Mo3tasemO/Graduation_Project/README.md

# Graduation Project

This repository will be for the Graduation Project.
