Mo3tasemO/Graduation_Project/Hardware_Design/Mind_Speak_(Main_Board)/BOM_LIST/Mind_Speak_(Main_Board).csv

Designator | Qty | Comment | DNP | Exclude from BOM | Exclude from Board | VENDOR | LINK | Footprint | Datasheet
C1,C29,C31,C33,C42,C43 | 6 | 10uF |  |  |  | LCSC | https://www.lcsc.com/product-detail/C710916.html?s_z=n_q_GRM188C80G106KE47D | PCM_SparkFun-Capacitor:C_0603_1608Metric | https://cdn.sparkfun.com/assets/8/a/4/a/5/Kemet_Capacitor_Datasheet.pdf
C2,C10,C11,C17,C18,C26,C32,C41 | 8 | 0.1uF |  |  |  | Mouser | https://www2.mouser.com/en/ProductDetail/YAGEO/CC0402KRX7R7BB104?qs=AgBp2OyFlx%252BSOyhfyS7hpw%3D%3D | PCM_SparkFun-Capacitor:C_0402_1005Metric | https://cdn.sparkfun.com/assets/8/a/4/a/5/Kemet_Capacitor_Datasheet.pdf
C3,C6,C7,C13,C14,C19,C20,C21,C24,C30,C34,C35 | 12 | 1.0uF |  |  |  | Mouser | https://www2.mouser.com/en/ProductDetail/YAGEO/CC0402KRX7R5BB105?qs=HEu%2FF%2FCqxzJ6VbuCv2R5Zg%3D%3D | PCM_SparkFun-Capacitor:C_0402_1005Metric | https://cdn.sparkfun.com/assets/8/a/4/a/5/Kemet_Capacitor_Datasheet.pdf
C4,C16 | 2 | 100uF |  |  |  | Mouser | https://www2.mouser.com/en/ProductDetail/YAGEO/CC1206MKX5R5BB107?qs=57cj7OiSijmA1unmqOkHVw%3D%3D | PCM_SparkFun-Capacitor:C_1206_3216Metric | https://mm.digikey.com/Volume0/opasdata/d220001/medias/docus/7134/c02e.pdf
C5,C9,C12,C15,C25,C27 | 6 | 2.2uF |  |  |  | Mouser | https://www2.mouser.com/en/ProductDetail/Murata-Electronics/GRM155R61C225KE44D?qs=K0Sa7bCb58LeAAXFhnh74A%3D%3D | PCM_SparkFun-Capacitor:C_0402_1005Metric | https://cdn.sparkfun.com/assets/8/a/4/a/5/Kemet_Capacitor_Datasheet.pdf
C8,C22,C28,C36,C38 | 5 | 0.001uF |  |  |  | **Mouser | https://eu.mouser.com/en/ProductDetail/TDK/CKCL44X7R1H102M085AA?qs=NRhsANhppD9%2Fh8FD6DWiRQ%3D%3D | TDK_Library:CKCL44_TDK | CKCL44X7R1H102M085AA
C23 | 1 | 0.01uF |  |  |  | Mouser | https://www2.mouser.com/en/ProductDetail/YAGEO/CC0402KRX7R7BB103?qs=AgBp2OyFlx8cKvXdhdEm3Q%3D%3D | SparkFun-Capacitor:C_0402_1005Metric | https://cdn.sparkfun.com/assets/8/a/4/a/5/Kemet_Capacitor_Datasheet.pdf
C37 | 1 | 1.0nF |  |  |  | Mouser | https://www2.mouser.com/en/ProductDetail/YAGEO/CC0402KRX7R7BB102?qs=cQA0dC2V9ENjYxMNJXN2bg%3D%3D | PCM_SparkFun-Capacitor:C_0402_1005Metric | https://cdn.sparkfun.com/assets/8/a/4/a/5/Kemet_Capacitor_Datasheet.pdf
C39,C40 | 2 | 18pF |  |  |  | Mouser | https://www2.mouser.com/en/ProductDetail/YAGEO/CC0402JRNPO9BN180?qs=AgBp2OyFlx8ARaqa%252Br5VgQ%3D%3D | PCM_SparkFun-Capacitor:C_0402_1005Metric | https://cdn.sparkfun.com/assets/8/a/4/a/5/Kemet_Capacitor_Datasheet.pdf
D1,D2,D3,D4,D5,D6 | 6 | TPD4E1B06DCKR |  |  |  | Mouser | https://www2.mouser.com/en/ProductDetail/Texas-Instruments/TPD4E1B06DCKR?qs=FBI%252BX3tnPf1Bt8uBkGhcNg%3D%3D | TI_Library:TVS_TPD4E1B06DCKR
D7 | 1 | Blue |  |  |  | Mouser | https://www2.mouser.com/en/ProductDetail/LITEON/LTST-C193TBKT-5A?qs=xIkB7y1OTorvzzuuxuVkOA%3D%3D | PCM_SparkFun-LED:LED_0603_1608Metric_Blue | https://media.digikey.com/pdf/Data%20Sheets/Rohm%20PDFs/SMLE12_Series_Rev2.0_2007.pdf
J1 | 1 | microSD |  |  |  | Mouser | https://www2.mouser.com/en/ProductDetail/Same-Sky/MSD-1-A?qs=Z%252BL2brAPG1Ip18XLC4tUPQ%3D%3D | SparkFun-Connector:CUI_MSD-1-A | https://cdn.sparkfun.com/assets/a/d/6/0/8/microSD_Datasheet_msd-1-a.pdf
J2,J4 | 2 | Conn_01x04_Pin |  |  |  | MicroOhm | https://microohm-eg.com/pin-header-2-54mm-1x40-pin-male-single-row-straight-short-header-strip/ | Connector_PinHeader_2.54mm:PinHeader_1x04_P2.54mm_Vertical
J3 | 1 | Conn_02x13_Odd_Even |  |  |  | MicroOhm | https://microohm-eg.com/2-54mm-0-100-pin-header-male-2x40-right-angle/ | Connector_PinHeader_2.54mm:PinHeader_2x13_P2.54mm_Horizontal
J5 | 1 | Conn_01x08_Pin |  |  |  | MicroOhm | https://microohm-eg.com/pin-header-2-54mm-1x40-pin-male-single-row-straight-short-header-strip/ | Connector_PinHeader_2.54mm:PinHeader_1x08_P2.54mm_Vertical
J6 | 1 | Conn_01x02_Pin |  |  |  | MicroOhm | https://microohm-eg.com/pin-header-2-54mm-1x40-pin-male-single-row-straight-short-header-strip/ | Connector_PinHeader_2.54mm:PinHeader_1x02_P2.54mm_Vertical
J7,J8 | 2 | Conn_01x05_Pin |  |  |  | MicroOhm | https://microohm-eg.com/pin-header-2-54mm-1x40-pin-male-single-row-straight-short-header-strip/ | Connector_PinHeader_2.54mm:PinHeader_1x05_P2.54mm_Vertical
P1 | 1 | S2B-PH-SM4-TB_LF__SN_ |  |  |  | LCSC | https://www.lcsc.com/product-detail/C295747.html | JST_Library:JST_S2B-PH-SM4-TB_LF__SN_
R1 | 1 | 1M |  |  |  | Mouser | https://www2.mouser.com/en/ProductDetail/YAGEO/RC0402JR-071ML?qs=uM1JSSdPjOCNcwoUm19Cag%3D%3D | SparkFun-Resistor:R_0402_1005Metric | https://www.vishay.com/docs/20035/dcrcwe3.pdf
R2 | 1 | 1K |  |  |  | Mouser | https://www2.mouser.com/en/ProductDetail/YAGEO/RT0402FRE071KL?qs=BXCcY9r%252B08AJmLKodK5LLA%3D%3D | SparkFun-Resistor:R_0402_1005Metric | https://www.vishay.com/docs/20035/dcrcwe3.pdf
R3,R4 | 2 | 470K |  |  |  | Mouser | https://www2.mouser.com/en/ProductDetail/YAGEO/RC0402JR-07470KL?qs=uM1JSSdPjODkyS3O7Vrt5Q%3D%3D | SparkFun-Resistor:R_0402_1005Metric | https://www.vishay.com/docs/20035/dcrcwe3.pdf
RN1,RN2,RN3,RN4,RN5 | 5 | CAY16-2201F4LF |  |  |  | Mouser | https://www2.mouser.com/en/ProductDetail/Bourns/CAY16-2201F4LF?qs=tEaODSGlU8NX5flyk%2FHGvg%3D%3D | Bourns_Library:RESCAF80P320X160X60-8N
S1 | 1 | SSSS811101 |  |  |  | LCSC | https://www.lcsc.com/product-detail/C109335.html | ALPS_Library:SW_SSSS811101
SW1,SW2,SW3 | 3 | SW_MEC_5E |  |  |  | Mouser | https://www2.mouser.com/en/ProductDetail/CK/PTS810SJK250SMTR-LFS?qs=Imq1NPwxi77Ow0tzRIznfA%3D%3D | Button_Switch_SMD:SW_Push_1P1T_NO_Vertical_Wuerth_434133025816 | https://www.apem.com/medias/download/MEC_switches_serie_MULTIMEC5E.pdf
U1 | 1 | SN74LVC1G32DCKR |  |  |  | Mouser | https://www2.mouser.com/en/ProductDetail/Texas-Instruments/SN74LVC1G32DCKR?qs=rshUhwi3fbYur8p35NB%252BLQ%3D%3D | TI_Library:SOT65P210X110-5N
U2 | 1 | TPS60403DBV |  |  |  | LCSC | https://www.lcsc.com/product-detail/C11338.html?s_z=n_q_TPS60403DBVR | Package_TO_SOT_SMD:SOT-23-5 | https://www.ti.com/lit/ds/symlink/tps60401.pdf
U3 | 1 | CDBU0130L |  |  |  | Mouser | https://www2.mouser.com/en/ProductDetail/Comchip-Technology/CDBU0130L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 | Comchip_Library:CDBU | CDBU0130L
U4 | 1 | LIS3DH |  |  |  | Mouser | https://www2.mouser.com/en/ProductDetail/STMicroelectronics/LIS3DHTR?qs=6la6oa3D8xzhXYax3cEo4w%3D%3D | PCM_SparkFun-Sensor:ST_LGA-16_3x3mm_P0.5mm_5x3 | https://www.st.com/en/mems-and-sensors/lis3dh.html
U5 | 1 | LP5907MFX-3.3 |  |  |  | Mouser | https://www2.mouser.com/en/ProductDetail/Texas-Instruments/LP5907MFX-3.3-NOPB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 | PCM_SparkFun-Semiconductor-Standard:SOT23-5 | http://www.ti.com/lit/ds/symlink/lp5907.pdf
U6 | 1 | TPS72325DBVR |  |  |  | Mouser | https://www.lcsc.com/product-detail/C69932.html?s_z=n_q_TPS72325DBVR | Package_TO_SOT_SMD:SOT-23-5 | https://www.ti.com/lit/ds/symlink/tps723.pdf
U7 | 1 | TLV70025_SOT23-5 |  |  |  | Mouser | https://www2.mouser.com/en/ProductDetail/Texas-Instruments/TLV70025QDDCRQ1?qs=NiBvnJE4bX1tmxoZbCukhA%3D%3D | Package_TO_SOT_SMD:SOT-23-5 | http://www.ti.com/lit/ds/symlink/tlv700.pdf
U8 | 1 | ADS1299 |  |  |  | Mouser | https://www2.mouser.com/en/ProductDetail/Texas-Instruments/ADS1299IPAG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 | Package_QFP:TQFP-64_10x10mm_P0.5mm | https://www.ti.com/lit/ds/symlink/ads1299.pdf
U9 | 1 | NINA-B30x |  |  |  | Mouser | https://www2.mouser.com/en/ProductDetail/u-blox/NINA-B306-01B?qs=HBWAp0VN4RjRrjBx%252B921jQ%3D%3D | U_Blox_Library:XCVR_NINA-B306-00B
U10 | 1 | PIC32MX250F128B-I_SS |  |  |  | Mouser | https://www2.mouser.com/en/ProductDetail/Microchip-Technology/PIC32MX250F128B-I-SS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 | MicroChip_Library:SOP65P780X200-28N
Y1 | 1 | ABMM2-8.000MHZ-E2-T |  |  |  | Mouser | https://eu.mouser.com/en/ProductDetail/ABRACON/ABMM2-8.000MHZ-E2-T?qs=m%252BUhWDcpCfaGlLHGChx47g%3D%3D | Abracon_Library:XTAL_ABMM2-8.000MHZ-E2-T
