Mo3tasemO/Graduation_Project/(list of files, drawings)

Other design files:
Hardware_Design/Simulation/Hardware_Sim/MindSpeak.pdsprj
