Mo3tasemO/Graduation_Project/Hardware_Design/Mind_Speak_(Main_Board)/Mind_Speak_(Main_Board).kicad_pcb

## KiCad design Hardware_Design/Mind_Speak_(Main_Board)/Mind_Speak_(Main_Board).kicad_pcb (2026-09-20)

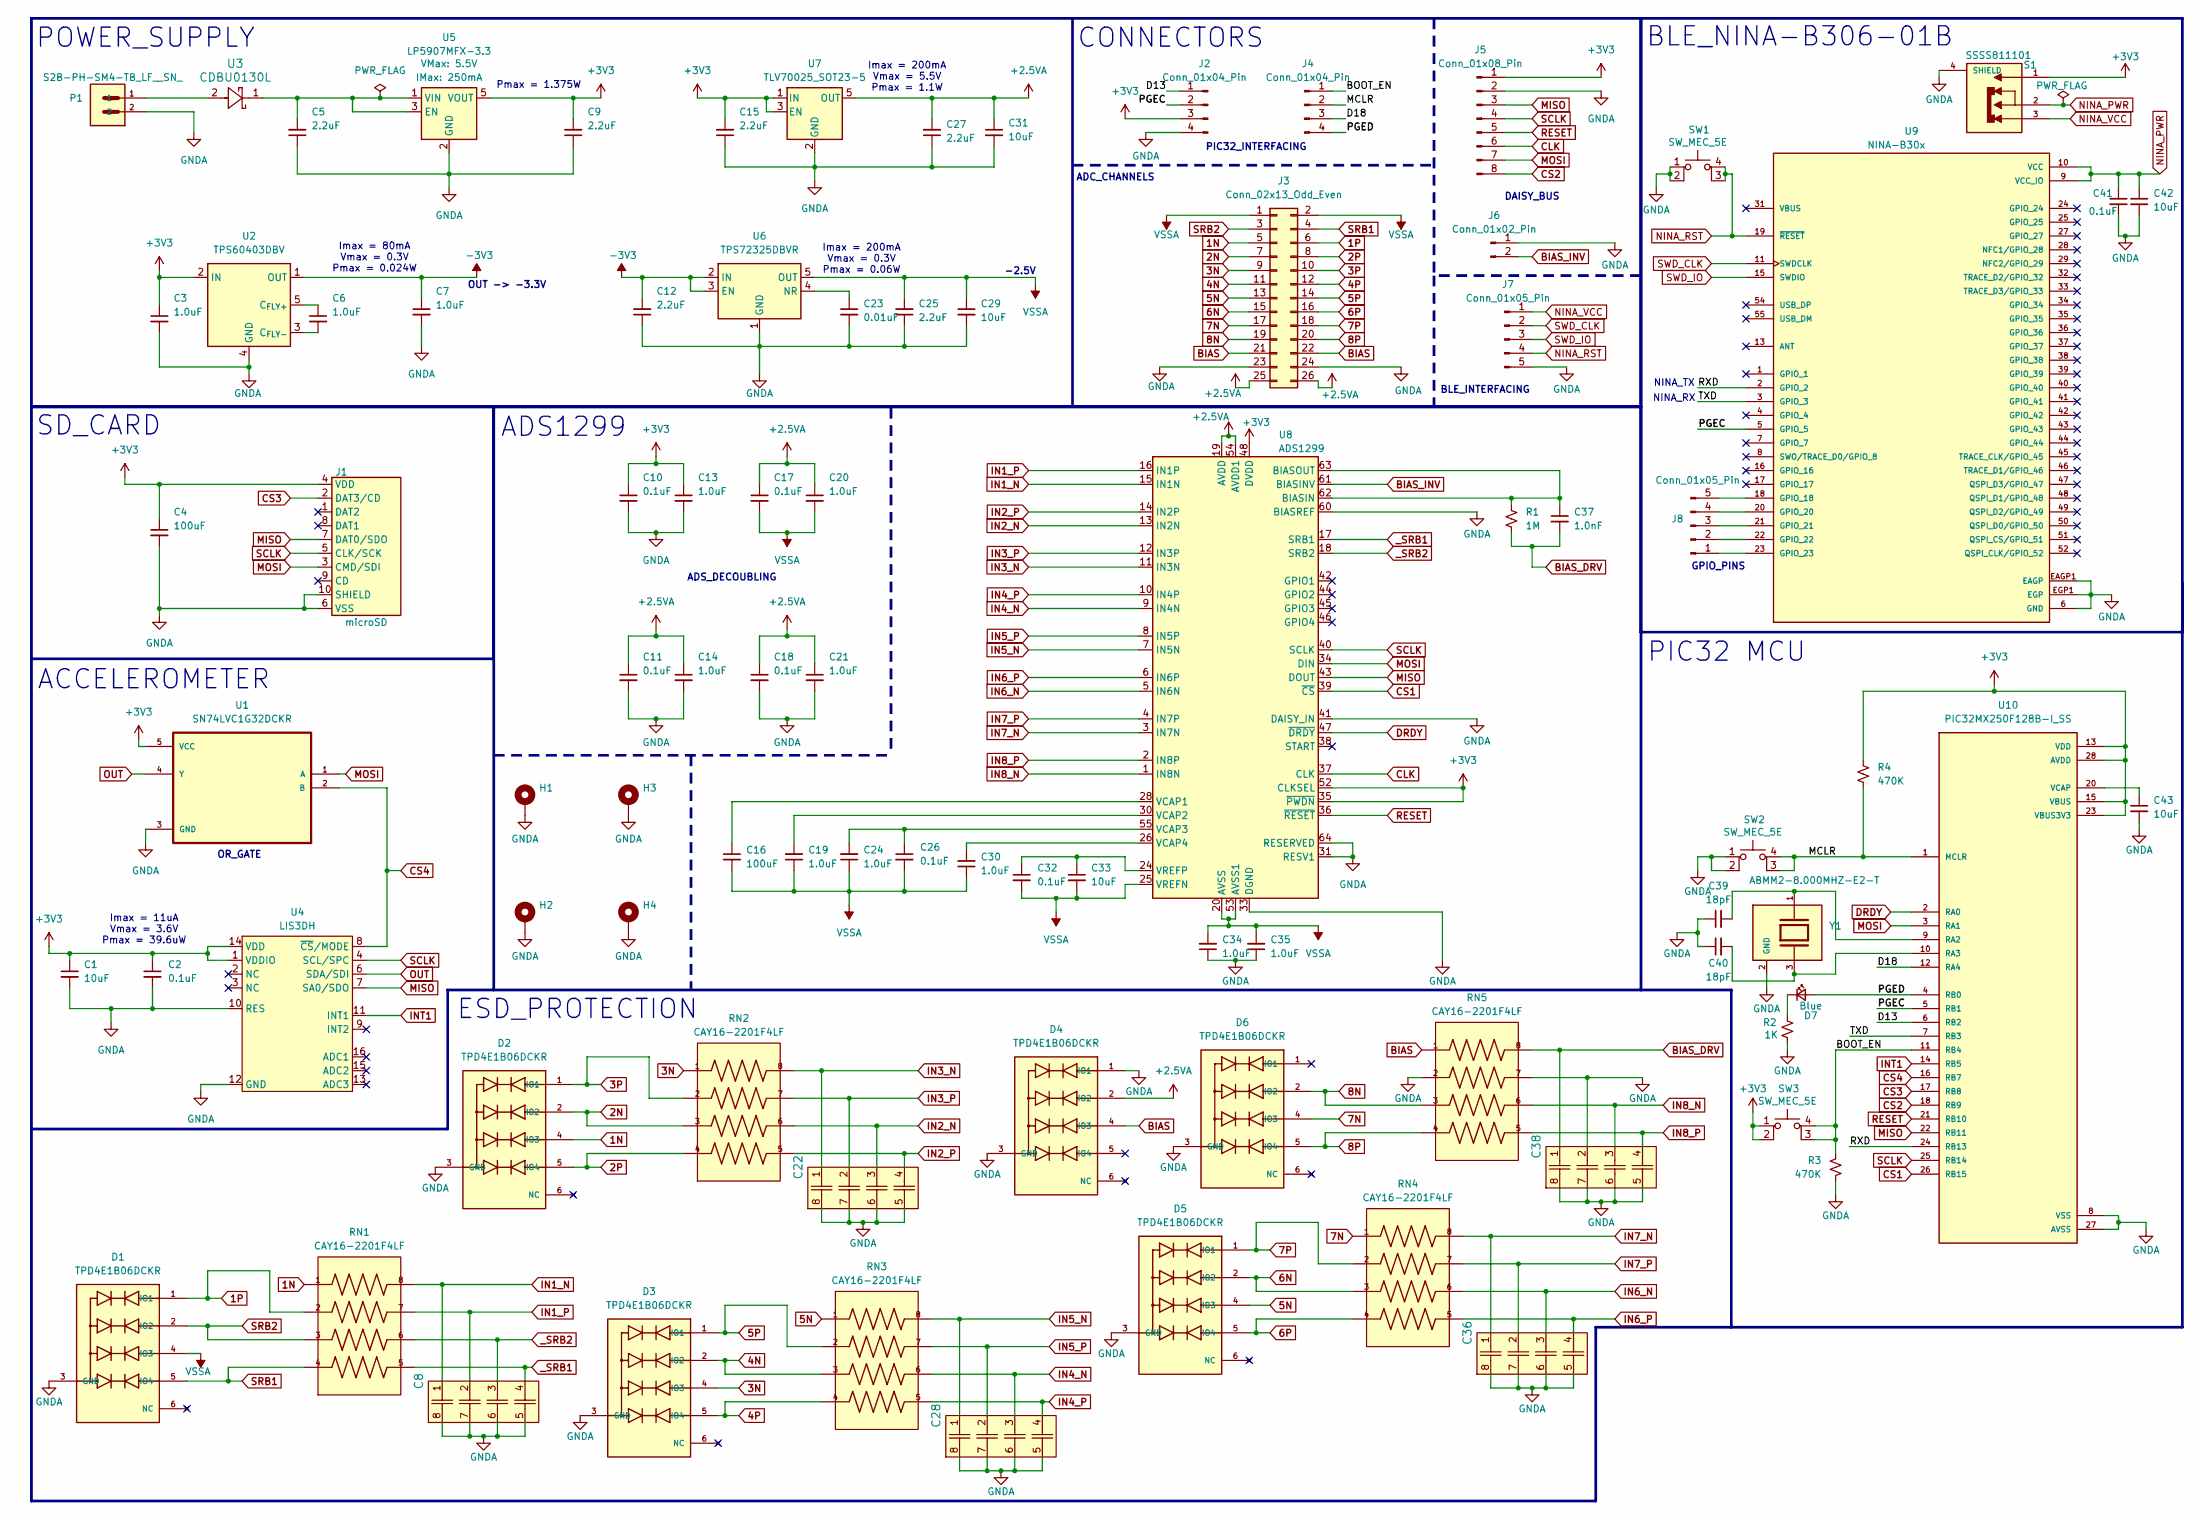
[picture p1: schematic Mind_Speak_(Main_Board).kicad_sch, MindSpeak_(Main_Board)]

Parts:
C1, C29, C31, C33, C42, C43: 10uF; C_0603_1608Metric; Voltage 10V; Tolerance 20%
C2, C10, C11, C17, C18, C26, C32, C41: 0.1uF; C_0402_1005Metric; Voltage 16V; Tolerance 10%
C3, C6, C7, C13, C14, C19, C20, C21, C24, C30, C34, C35: 1.0uF; C_0402_1005Metric; Voltage 16V; Tolerance 10%
C4, C16: 100uF; C_1206_3216Metric; Voltage 10V; Tolerance 20%
C5, C9, C12, C15, C25, C27: 2.2uF; C_0402_1005Metric; Voltage 10V; Tolerance 10%
C8, C22, C28, C36, C38: 0.001uF; CKCL44_TDK
C23: 0.01uF; C_0402_1005Metric; Voltage 25V; Tolerance 10%
C37: 1.0nF; C_0402_1005Metric; Voltage 50V; Tolerance 10%
C39, C40: 18pF; C_0402_1005Metric; Voltage 50V; Tolerance 5%
D1, D2, D3, D4, D5, D6: TPD4E1B06DCKR; TVS_TPD4E1B06DCKR; PARTREV C
D7: Blue; LED_0603_1608Metric_Blue
H1, H2, H3, H4: MountingHole_Pad; MountingHole_3.2mm_M3_Pad
J1: microSD; CUI_MSD-1-A
J2, J4: Conn_01x04_Pin; PinHeader_1x04_P2.54mm_Vertical
J3: Conn_02x13_Odd_Even; PinHeader_2x13_P2.54mm_Horizontal
J5: Conn_01x08_Pin; PinHeader_1x08_P2.54mm_Vertical
J6: Conn_01x02_Pin; PinHeader_1x02_P2.54mm_Vertical
J7, J8: Conn_01x05_Pin; PinHeader_1x05_P2.54mm_Vertical
P1: S2B-PH-SM4-TB_LF__SN_; JST_S2B-PH-SM4-TB_LF__SN_
R1: 1M; R_0402_1005Metric
R2: 1K; R_0402_1005Metric
R3, R4: 470K; R_0402_1005Metric
RN1, RN2, RN3, RN4, RN5: CAY16-2201F4LF; RESCAF80P320X160X60-8N
S1: SSSS811101; SW_SSSS811101; PARTREV N/A
SW1, SW2, SW3: SW_MEC_5E; SW_Push_1P1T_NO_Vertical_Wuerth_434133025816
U1: SN74LVC1G32DCKR; SOT65P210X110-5N
U2: TPS60403DBV; SOT-23-5
U3: CDBU0130L; CDBU
U4: LIS3DH; ST_LGA-16_3x3mm_P0.5mm_5x3
U5: LP5907MFX-3.3; SOT23-5
U6: TPS72325DBVR; SOT-23-5
U7: TLV70025_SOT23-5; SOT-23-5
U8: ADS1299; TQFP-64_10x10mm_P0.5mm
U9: NINA-B30x; XCVR_NINA-B306-00B; PARTREV R07
U10: PIC32MX250F128B-I_SS; SOP65P780X200-28N
Y1: ABMM2-8.000MHZ-E2-T; XTAL_ABMM2-8.000MHZ-E2-T; PARTREV 01.18.13

Connections:
1N: D2.4 (IO3), J3.5, RN1.1
1P: D1.1 (IO1), J3.6, RN1.2
2N: D2.2 (IO2), J3.7, RN2.3
2P: D2.5 (IO4), J3.8, RN2.4
3N: D3.4 (IO3), J3.9, RN2.1
3P: D2.1 (IO1), J3.10, RN2.2
4N: D3.2 (IO2), J3.11, RN3.3
4P: D3.5 (IO4), J3.12, RN3.4
5N: D5.4 (IO3), J3.13, RN3.1
5P: D3.1 (IO1), J3.14, RN3.2
6N: D5.2 (IO2), J3.15, RN4.3
6P: D5.5 (IO4), J3.16, RN4.4
7N: D6.4 (IO3), J3.17, RN4.1
7P: D5.1 (IO1), J3.18, RN4.2
8N: D6.2 (IO2), J3.19, RN5.3
8P: D6.5 (IO4), J3.20, RN5.4
+2.5VA: C11.1, C14.1, C17.1, C18.1, C20.1, C21.1, C27.2, C31.1, D4.2 (IO2), J3.25, J3.26, U7.5 (OUT), U8.19 (AVDD), U8.21 (AVDD), U8.22 (AVDD), U8.54 (AVDD1), U8.56 (AVDD), U8.59 (AVDD)
+3V3: C1.1, C2.1, C3.1, C4.1, C9.2, C10.1, C13.1, C15.2, J1.4 (VDD), J2.3, J5.1, R4.2, S1.1, SW3.1, SW3.2, U1.5 (VCC), U2.2 (IN), U4.1 (VDDIO), U4.14 (VDD), U5.5 (VOUT), U7.1 (IN), U7.3 (EN), U8.35 (~PWDN), U8.48 (DVDD), U8.50 (DVDD), U8.52 (CLKSEL), U10.13 (VDD), U10.15 (VBUS), U10.23 (VBUS3V3), U10.28 (AVDD)
-3V3: C7.1, C12.2, U2.1 (OUT), U6.2 (IN), U6.3 (EN)
/BOOT_EN: J4.1, R3.2, SW3.3 (K), SW3.4 (A), U10.11 (RB4)
/D13: J2.1, U10.6 (RB2)
/D18: J4.3, U10.12 (RA4)
/MCLR: J4.2, R4.1, SW2.3 (K), SW2.4 (A), U10.1 (MCLR)
/PGEC: J2.2, U9.5 (GPIO_5), U10.5 (RB1)
/PGED: D7.2 (A), J4.4, U10.4 (RB0)
/RXD: U9.2 (GPIO_2), U10.24 (RB13)
/TXD: U9.3 (GPIO_3), U10.7 (RB3)
BIAS: D4.4 (IO3), J3.21, J3.22, RN5.1
BIAS_DRV: C37.2, C38.1, R1.1, RN5.8
BIAS_INV: J6.2, U8.61 (BIASINV)
CLK: J5.6, U8.37 (CLK)
CS1: U8.39 (~CS), U10.26 (RB15)
CS2: J5.8, U10.18 (RB9)
CS3: J1.2 (DAT3/CD), U10.17 (RB8)
CS4: U1.2 (B), U4.8 (~CS/MODE), U10.16 (RB7)
DRDY: U8.47 (~DRDY), U10.2 (RA0)
GNDA: C1.2, C2.2, C3.2, C4.2, C5.1, C7.2, C8.5, C8.6, C8.7, C8.8, C9.1, C10.2, C11.2, C12.1, C13.2, C14.2, C15.1, C18.2, C21.2, C22.5, C22.6, C22.7, C22.8, C23.2, C25.1, C27.1, C28.5, C28.6, C28.7, C28.8, C29.2, C31.2, C34.1, C35.1, C36.5, C36.6, C36.7, C36.8, C38.2, C38.5, C38.6, C38.7, C38.8, C39.1, C40.1, C41.2, C42.2, C43.2, D1.3 (GND), D2.3 (GND), D3.3 (GND), D4.1 (IO1), D4.3 (GND), D5.3 (GND), D6.3 (GND), H1.1 (1_1), H2.1 (1_1), H3.1 (1_1), H4.1 (1_1), J1.6 (VSS), J1.10 (SHIELD), J2.4, J3.23, J3.24, J5.2, J6.1, J7.5, P1.2, R2.1, R3.1, RN5.2, RN5.7, S1.4 (SHIELD_4), SW1.1, SW1.2, SW2.1, SW2.2, U1.3 (GND), U2.4 (GND), U4.5 (GND), U4.10 (RES), U4.12 (GND), U5.2 (GND), U6.1 (GND), U7.2 (GND), U8.31 (RESV1), U8.33 (DGND), U8.41 (DAISY_IN), U8.49 (DGND), U8.51 (DGND), U8.60 (BIASREF), U8.64 (RESERVED), U9.6 (GND), U9.12 (GND), U9.14 (GND), U9.26 (GND), U9.30 (GND), U9.53 (GND), U9.EAGP1 (EAGP), U9.EAGP2 (EAGP), U9.EAGP3 (EAGP), U9.EAGP4 (EAGP), U9.EGP1 (EGP), U9.EGP2 (EGP), U9.EGP3 (EGP), U9.EGP4 (EGP), U9.EGP5 (EGP), U9.EGP6 (EGP), U9.EGP7 (EGP), U9.EGP8 (EGP), U9.EGP9 (EGP), U9.EGP10 (EGP), U9.EGP11 (EGP), U9.EGP12 (EGP), U10.8 (VSS), U10.19 (VSS), U10.27 (AVSS), Y1.2 (GND), Y1.4 (GND)
IN1_N: C8.1, RN1.8, U8.15 (IN1N)
IN1_P: C8.2, RN1.7, U8.16 (IN1P)
IN2_N: C22.3, RN2.6, U8.13 (IN2N)
IN2_P: C22.4, RN2.5, U8.14 (IN2P)
IN3_N: C22.1, RN2.8, U8.11 (IN3N)
IN3_P: C22.2, RN2.7, U8.12 (IN3P)
IN4_N: C28.3, RN3.6, U8.9 (IN4N)
IN4_P: C28.4, RN3.5, U8.10 (IN4P)
IN5_N: C28.1, RN3.8, U8.7 (IN5N)
IN5_P: C28.2, RN3.7, U8.8 (IN5P)
IN6_N: C36.3, RN4.6, U8.5 (IN6N)
IN6_P: C36.4, RN4.5, U8.6 (IN6P)
IN7_N: C36.1, RN4.8, U8.3 (IN7N)
IN7_P: C36.2, RN4.7, U8.4 (IN7P)
IN8_N: C38.3, RN5.6, U8.1 (IN8N)
IN8_P: C38.4, RN5.5, U8.2 (IN8P)
INT1: U4.11 (INT1), U10.14 (RB5)
MISO: J1.7 (DAT0/SDO), J5.3, U4.7 (SA0/SDO), U8.43 (DOUT), U10.22 (RB11)
MOSI: J1.3 (CMD/SDI), J5.7, U1.1 (A), U8.34 (DIN), U10.3 (RA1)
NINA_PWR: C41.1, C42.1, S1.2, U9.9 (VCC_IO), U9.10 (VCC)
NINA_RST: J7.4, SW1.3 (K), SW1.4 (A), U9.19 (~RESET)
NINA_VCC: J7.1, S1.3
unnamed: D7.1 (K), R2.2
unnamed: J8.1, U9.23 (GPIO_23)
unnamed: J8.2, U9.22 (GPIO_22)
unnamed: J8.3, U9.21 (GPIO_21)
unnamed: J8.4, U9.20 (GPIO_20)
unnamed: J8.5, U9.18 (GPIO_18)
unnamed: P1.1, U3.2
unnamed: C6.1, U2.5 (C_{FLY+})
unnamed: C6.2, U2.3 (C_{FLY-})
unnamed: C5.2, U3.1, U5.1 (VIN), U5.3 (EN)
unnamed: C23.1, U6.4 (NR)
unnamed: C37.1, R1.2, U8.62 (BIASIN), U8.63 (BIASOUT)
unnamed: C16.1, U8.28 (VCAP1)
unnamed: C19.2, U8.30 (VCAP2)
unnamed: C24.2, C26.1, U8.55 (VCAP3)
unnamed: C30.2, U8.26 (VCAP4)
unnamed: C32.1, C33.1, U8.24 (VREFP)
unnamed: C39.2, U10.9 (RA2), Y1.1
unnamed: C40.2, U10.10 (RA3), Y1.3
unnamed: C43.1, U10.20 (VCAP)
OUT: U1.4 (Y), U4.6 (SDA/SDI)
RESET: J5.5, U8.36 (~RESET), U10.21 (RB10)
SCLK: J1.5 (CLK/SCK), J5.4, U4.4 (SCL/SPC), U8.40 (SCLK), U10.25 (RB14)
SRB1: D1.5 (IO4), J3.4, RN1.4
SRB2: D1.2 (IO2), J3.3, RN1.3
SWD_CLK: J7.2, U9.11 (SWDCLK)
SWD_IO: J7.3, U9.15 (SWDIO)
VSSA: C16.2, C17.2, C19.1, C20.2, C24.1, C25.2, C26.2, C29.1, C30.1, C32.2, C33.2, C34.2, C35.2, D1.4 (IO3), J3.1, J3.2, U6.5 (OUT), U8.20 (AVSS), U8.23 (AVSS), U8.25 (VREFN), U8.32 (AVSS), U8.53 (AVSS1), U8.57 (AVSS), U8.58 (AVSS)
_SRB1: C8.4, RN1.5, U8.17 (SRB1)
_SRB2: C8.3, RN1.6, U8.18 (SRB2)

Notes on the sheet:
CONNECTORS
Imax = 11uA Vmax = 3.6V Pmax = 39.6uW
POWER_SUPPLY
ADC_CHANNELS
ACCELEROMETER
Imax = 200mA Vmax = 5.5V Pmax = 1.1W
BLE_NINA-B306-01B
DAISY_BUS
-2.5V
ESD_PROTECTION
Pmax = 1.375W
PIC32_INTERFACING
NINA_RX
BLE_INTERFACING
ADS1299
Imax = 200mA Vmax = 0.3V Pmax = 0.06W
Imax = 80mA Vmax = 0.3V Pmax = 0.024W
SD_CARD
ADS_DECOUBLING
OR_GATE
OUT -> -3.3V
NINA_TX
GPIO_PINS
PIC32 MCU

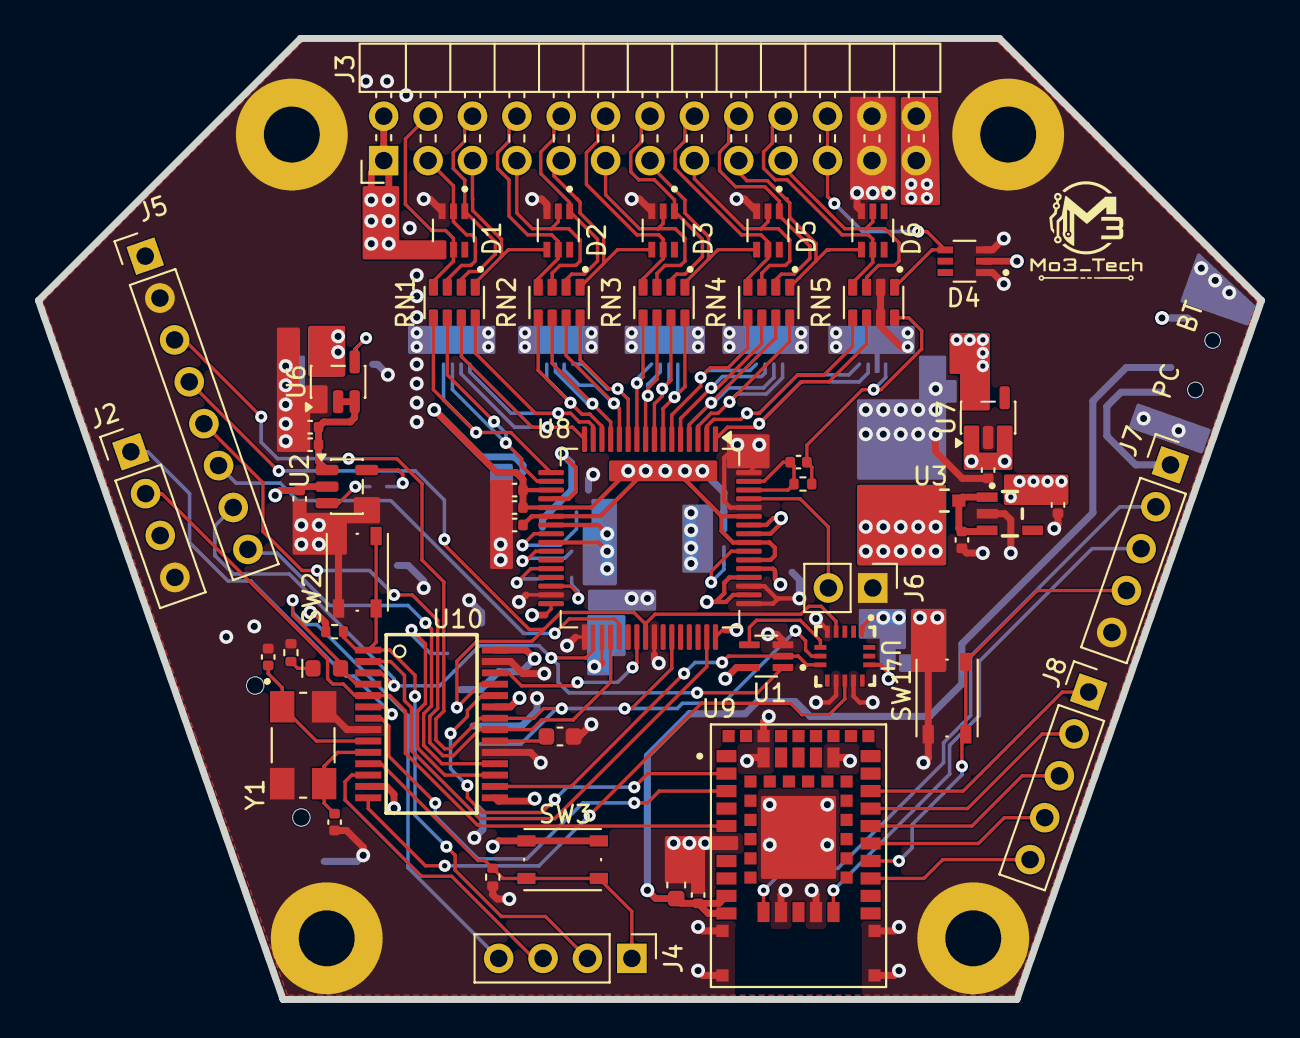
[picture p2: board Mind_Speak_(Main_Board).kicad_pcb from above]

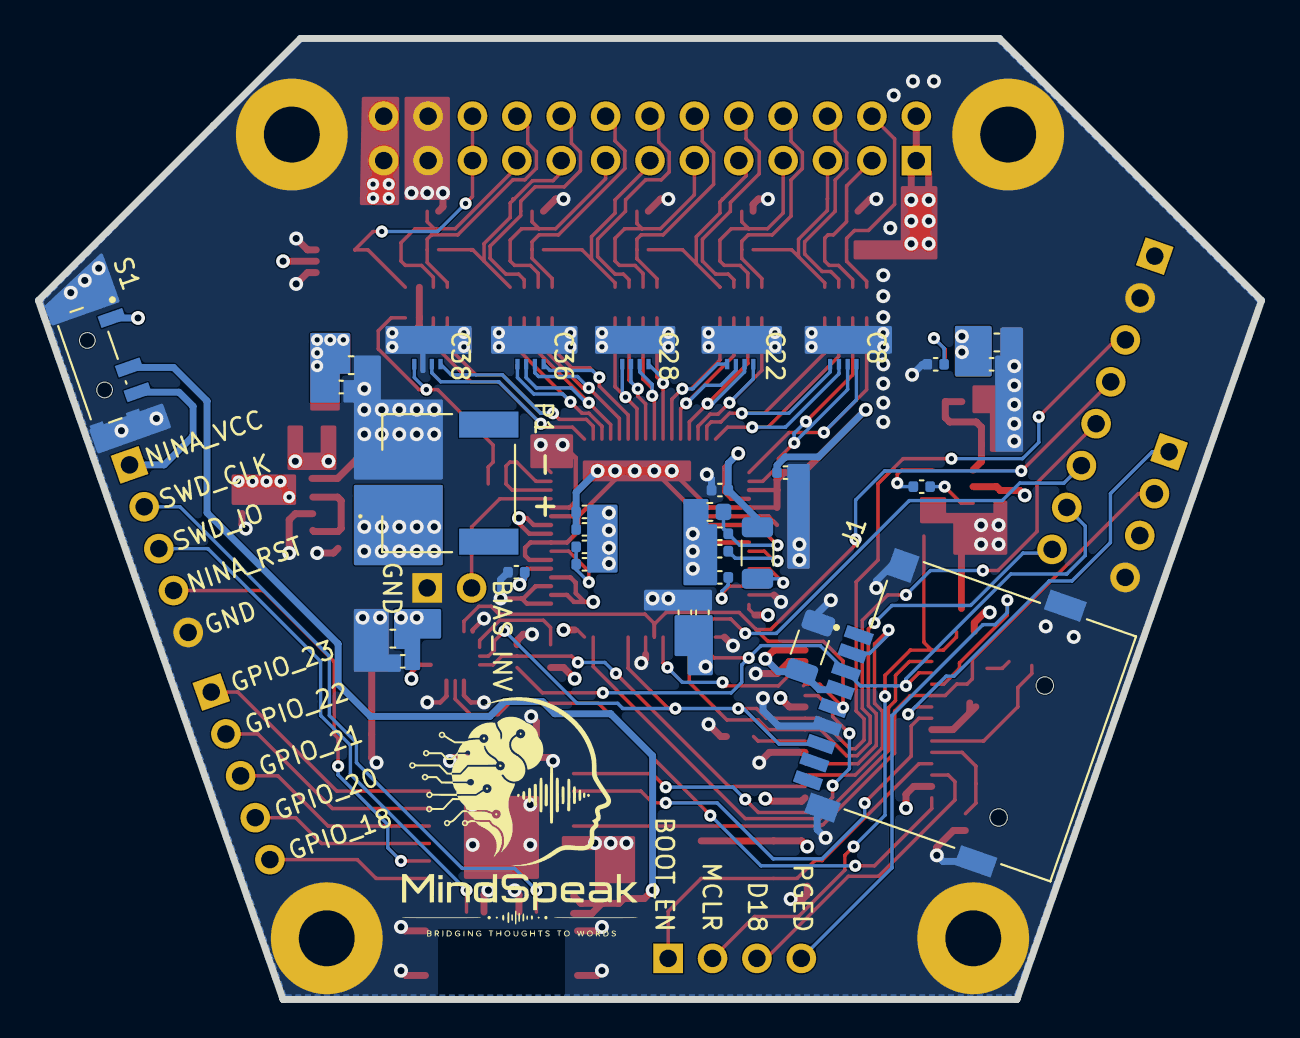
[picture p3: board Mind_Speak_(Main_Board).kicad_pcb from below]

Board: 4 copper layers, 70.0 x 55.0 mm, 87 parts (31 on the bottom side), 89 nets.
