Mo3tasemO/Graduation_Project/Hardware_Design/Mind_Speak_(Dongle_Board)/Mind_Speak_(Dongle_Board).kicad_pcb

## KiCad design Hardware_Design/Mind_Speak_(Dongle_Board)/Mind_Speak_(Dongle_Board).kicad_pcb (2026-09-20)

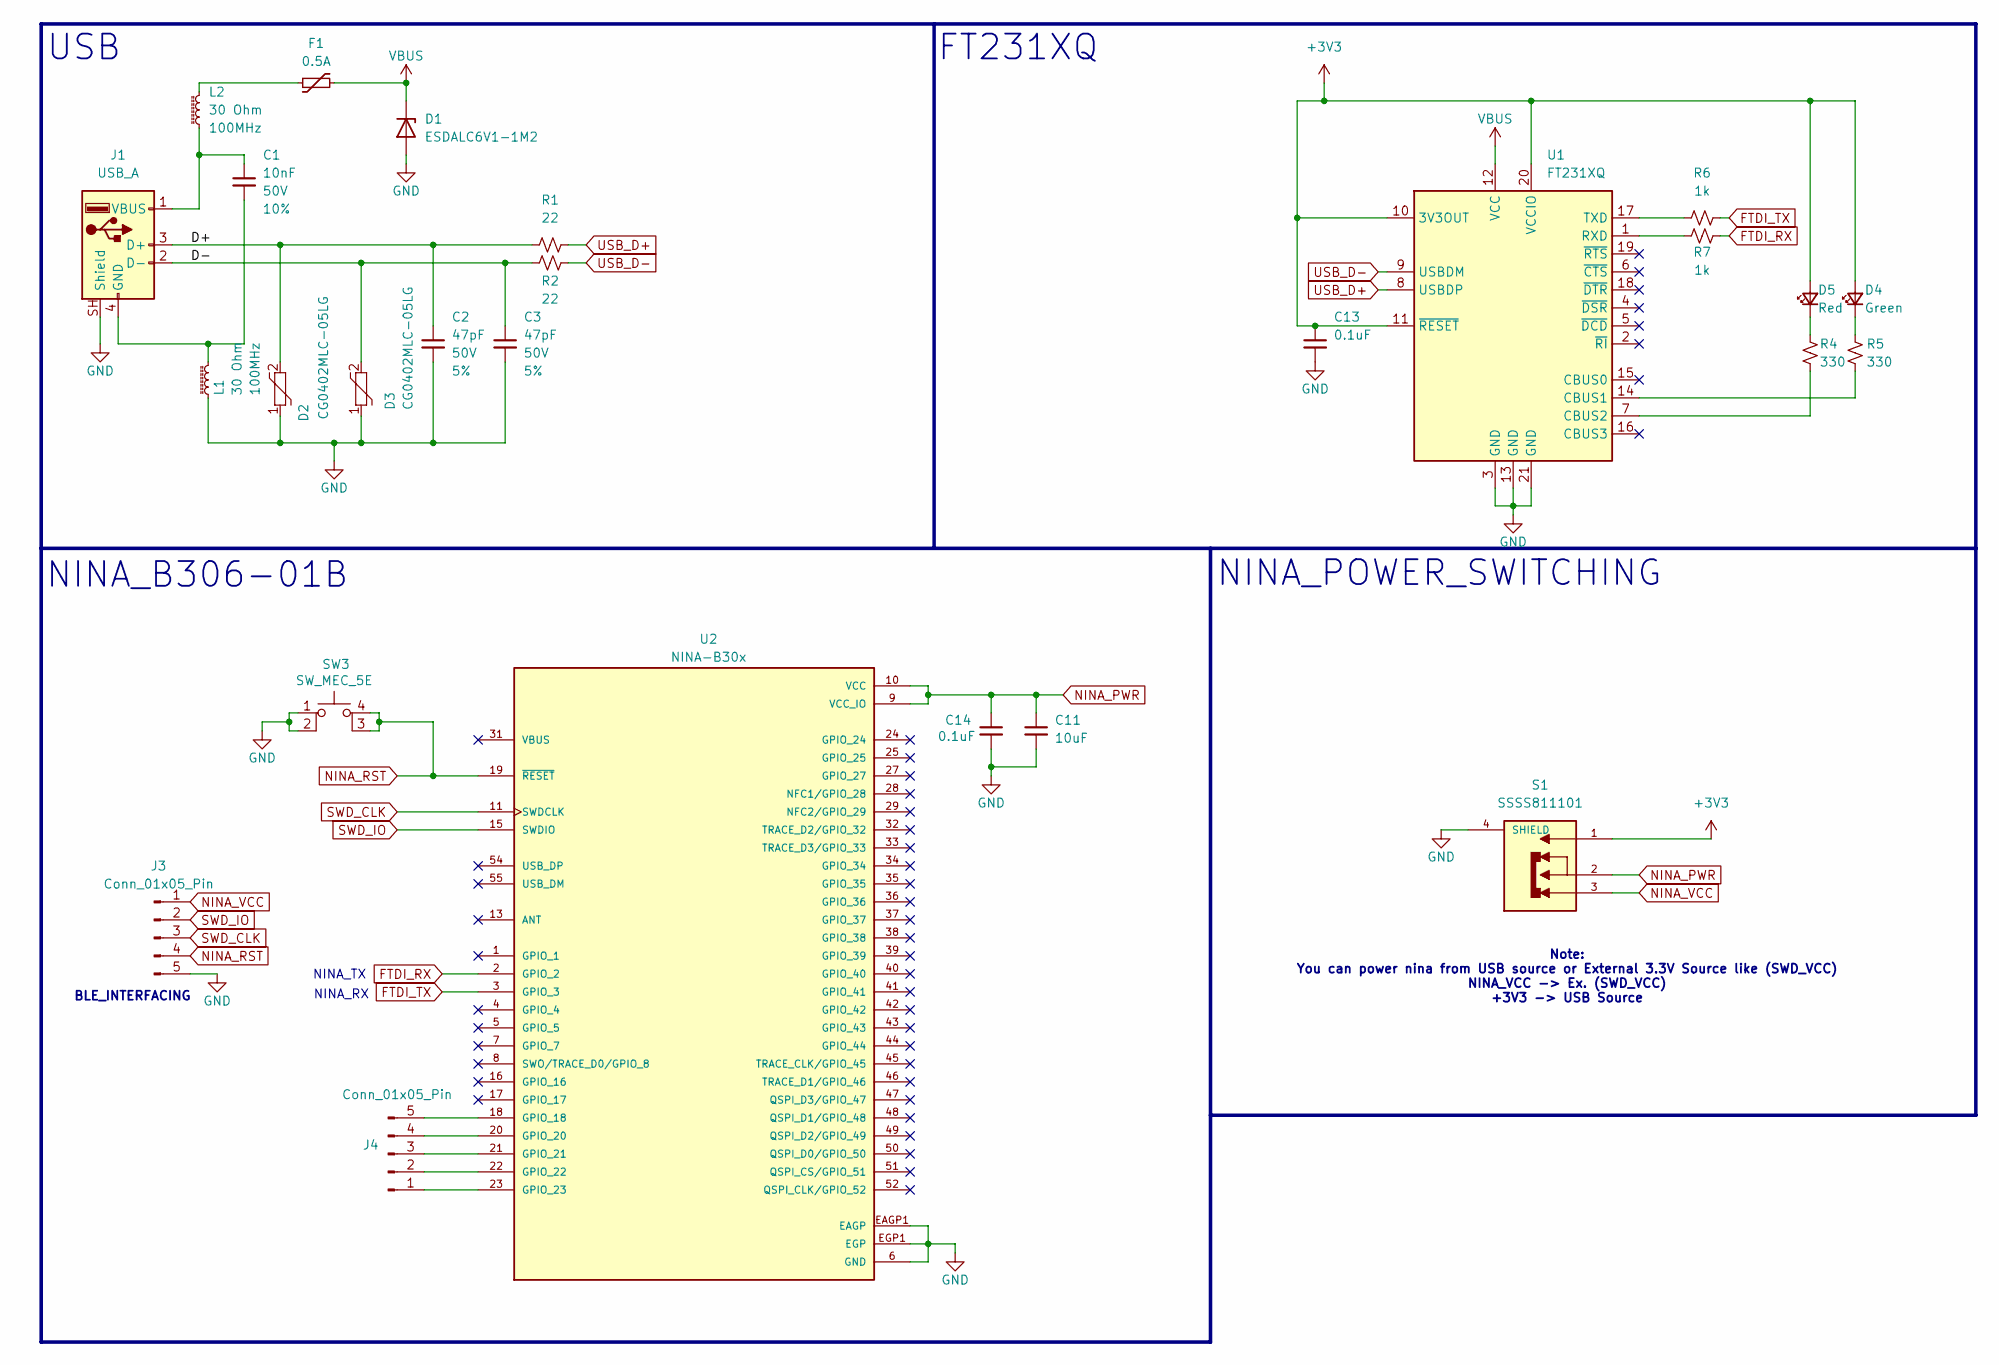
[picture p4: schematic Mind_Speak_(Dongle_Board).kicad_sch, MindSpeak_(Dongle_Board)]

Parts:
C1: 10nF; C_0402_1005Metric; Voltage 50V; Tolerance 10%
C2, C3: 47pF; C_0402_1005Metric; Voltage 50V; Tolerance 5%
C11: 10uF; C_0603_1608Metric; Voltage 10V; Tolerance 20%
C13, C14: 0.1uF; C_0402_1005Metric; Voltage 16V; Tolerance 10%
D1: ESDALC6V1-1M2; D_SOD-882
D2, D3: CG0402MLC-05LG
D4: Green; LED_0603_1608Metric_Green
D5: Red; LED_0603_1608Metric_Red
F1: 0.5A; 1812
J1: USB_A; MOLEX_48037-1000
J3, J4: Conn_01x05_Pin; PinHeader_1x05_P2.54mm_Vertical
L1, L2: 30 Ohm; C_0402_1005Metric
R1, R2: 22; R_0402_1005Metric
R4, R5: 330; R_0402_1005Metric
R6, R7: 1k; R_0402_1005Metric
S1: SSSS811101; SW_SSSS811101; PARTREV N/A
SW3: SW_MEC_5E; SW_Push_1P1T_NO_Vertical_Wuerth_434133025816
U1: FT231XQ; QFN-20-1EP_4x4mm_P0.5mm_EP2.5x2.5mm
U2: NINA-B30x; XCVR_NINA-B306-00B; PARTREV R07

Connections:
+3V3: C13.1, D4.2 (A), D5.2 (A), S1.1, U1.10 (3V3OUT), U1.11 (~RESET), U1.20 (VCCIO)
/D+: C2.1, D2.2, J1.3 (D+), R1.1
/D-: C3.1, D3.2, J1.2 (D-), R2.1
FTDI_RX: R7.2, U2.2 (GPIO_2)
FTDI_TX: R6.2, U2.3 (GPIO_3)
GND: C2.2, C3.2, C11.2, C13.2, C14.2, D1.2 (A), D2.1, D3.1, J1.SH (Shield), J3.5, L1.1, S1.4 (SHIELD_4), SW3.1, SW3.2, U1.3 (GND), U1.13 (GND), U1.21 (GND), U2.6 (GND), U2.12 (GND), U2.14 (GND), U2.26 (GND), U2.30 (GND), U2.53 (GND), U2.EAGP1 (EAGP), U2.EAGP2 (EAGP), U2.EAGP3 (EAGP), U2.EAGP4 (EAGP), U2.EGP1 (EGP), U2.EGP2 (EGP), U2.EGP3 (EGP), U2.EGP4 (EGP), U2.EGP5 (EGP), U2.EGP6 (EGP), U2.EGP7 (EGP), U2.EGP8 (EGP), U2.EGP9 (EGP), U2.EGP10 (EGP), U2.EGP11 (EGP), U2.EGP12 (EGP)
NINA_PWR: C11.1, C14.1, S1.2, U2.9 (VCC_IO), U2.10 (VCC)
NINA_RST: J3.4, SW3.3 (K), SW3.4 (A), U2.19 (~RESET)
NINA_VCC: J3.1, S1.3
unnamed: D4.1 (K), R5.2
unnamed: D5.1 (K), R4.2
unnamed: F1.1, L2.2
unnamed: C1.2, J1.4 (GND), L1.2
unnamed: C1.1, J1.1 (VBUS), L2.1
unnamed: J4.1, U2.23 (GPIO_23)
unnamed: J4.2, U2.22 (GPIO_22)
unnamed: J4.3, U2.21 (GPIO_21)
unnamed: J4.4, U2.20 (GPIO_20)
unnamed: J4.5, U2.18 (GPIO_18)
unnamed: R5.1, U1.14 (CBUS1)
unnamed: R4.1, U1.7 (CBUS2)
unnamed: R7.1, U1.1 (RXD)
unnamed: R6.1, U1.17 (TXD)
SWD_CLK: J3.3, U2.11 (SWDCLK)
SWD_IO: J3.2, U2.15 (SWDIO)
USB_D+: R1.2, U1.8 (USBDP)
USB_D-: R2.2, U1.9 (USBDM)
VBUS: D1.1 (K), F1.2, U1.12 (VCC)

Notes on the sheet:
Note: You can power nina from USB source or External 3.3V Source like (SWD_VCC) NINA_VCC -> Ex. (SWD_VCC) +3V3 -> USB Source
NINA_B306-01B
FT231XQ
BLE_INTERFACING
NINA_POWER_SWITCHING
NINA_TX
NINA_RX
USB

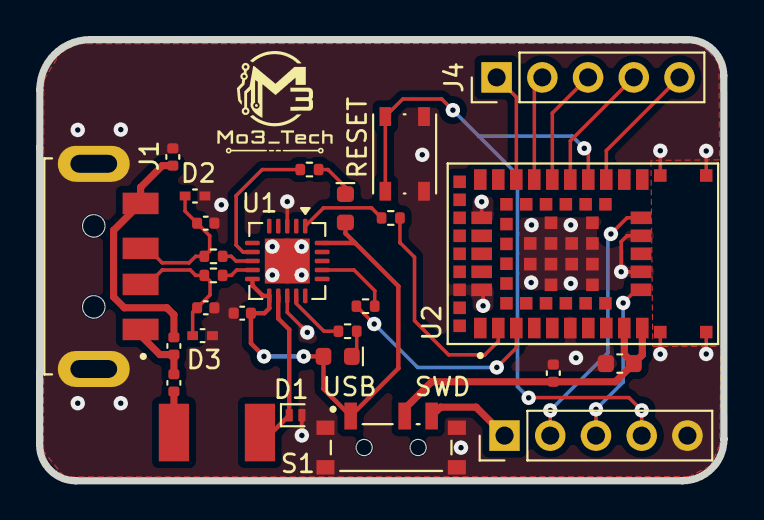
[picture p5: board Mind_Speak_(Dongle_Board).kicad_pcb from above]

Board: 2 copper layers, 38.0 x 24.5 mm, 28 parts (0 on the bottom side), 28 nets.

Other parts of the board:
G*: LOGO; MindSpeak_Logo
