Mo3tasemO/Graduation_Project/(commit log)

2026-07-15 Added the last update of the hardware design
    [Mind_Speak.kicad_pcb, Mind_Speak.kicad_sch]
2026-07-17 Edited The Schema
    [MindSpeak.pdsprj, Mind_Speak.kicad_sch]
2026-07-19 Edit in The Schematic
    [Mind_Speak.kicad_sch]
2026-07-21 Added Dongle Design
    [Mind_Speak_(Dongle_Board).kicad_pcb, Mind_Speak_(Dongle_Board).kicad_sch, Mind_Speak_(Main_Board).kicad_pcb, Mind_Speak_(Main_Board).kicad_sch]
2026-07-22 Edit In Dongle Board
    [Mind_Speak_(Dongle_Board).kicad_sch]
2026-07-25 Edit The main Board
    [Mind_Speak_(Dongle_Board).kicad_sch, Mind_Speak_(Main_Board).kicad_sch]
2026-07-31 Last Edit in main and dongle boards
    [Mind_Speak_(Dongle_Board).kicad_sch, Mind_Speak_(Main_Board).kicad_sch]
2026-08-08 Edit in Dongle Layout
    [Mind_Speak_(Dongle_Board).csv, Mind_Speak_(Dongle_Board).kicad_pcb, Mind_Speak_(Dongle_Board).kicad_sch, Mind_Speak_(Main_Board).csv, Mind_Speak_(Main_Board).kicad_sch]
2026-08-11 Dongle Layout Finished
    [Mind_Speak_(Dongle_Board).csv, Mind_Speak_(Dongle_Board).kicad_pcb, Mind_Speak_(Dongle_Board).kicad_sch]
2026-09-07 Edit In Layout Of Main Board
    [Mind_Speak_(Dongle_Board).kicad_pcb, Mind_Speak_(Dongle_Board).kicad_sch, Mind_Speak_(Main_Board).csv, Mind_Speak_(Main_Board).kicad_pcb, Mind_Speak_(Main_Board).kicad_sch]
2026-09-09 Last Edit In Layout Of Main Board
    [Mind_Speak_(Main_Board).kicad_pcb]
2026-09-20 Edit in Dongle/Main Boards
    [Mind_Speak_(Dongle_Board).kicad_pcb, Mind_Speak_(Dongle_Board).kicad_sch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]
2026-10-15 Last Update and Updated the BOM List
